cheehieu/usc-auv-kill-switch/images/IMAG0656.jpg

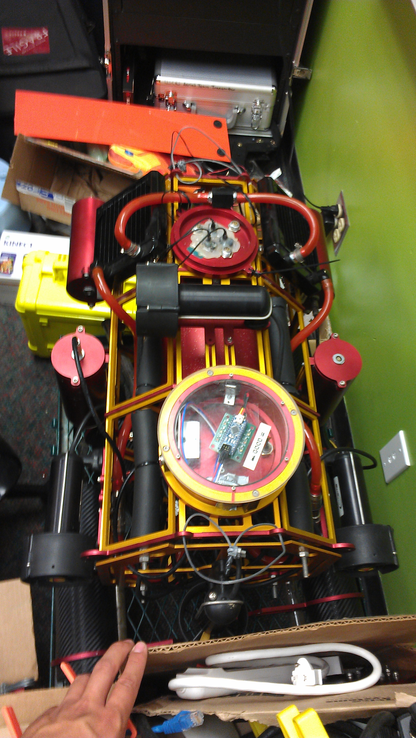
images/IMAG0656.jpg
