cheehieu/usc-auv-kill-switch/images/IMAG0652.jpg

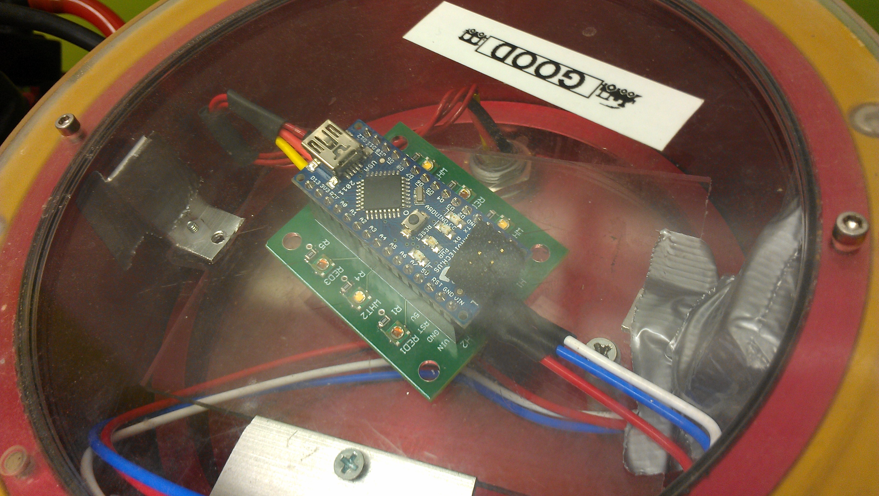
images/IMAG0652.jpg
