cheehieu/usc-auv-kill-switch/images/altium_killswitch.JPG

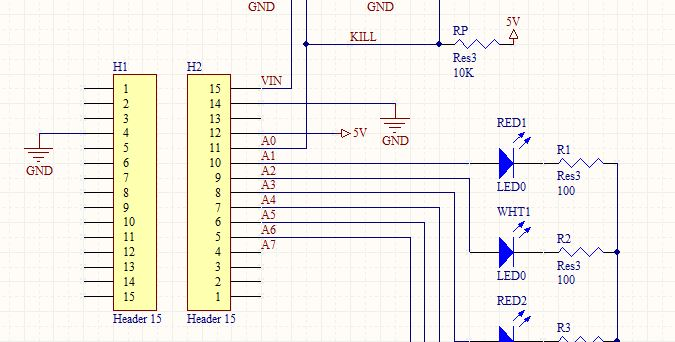
images/altium_killswitch.JPG
