cheehieu/usc-auv-kill-switch/images/CIMG3264.JPG

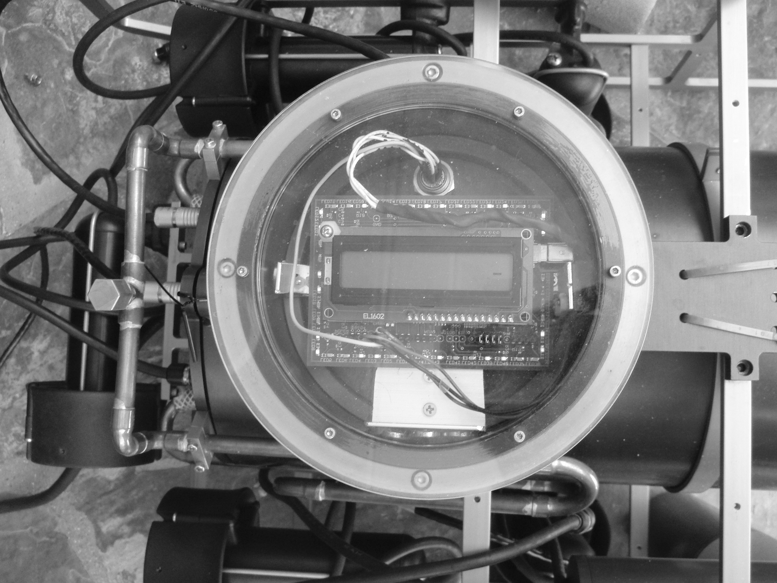
images/CIMG3264.JPG
