cheehieu/usc-auv-kill-switch/images/CIMG3785.JPG

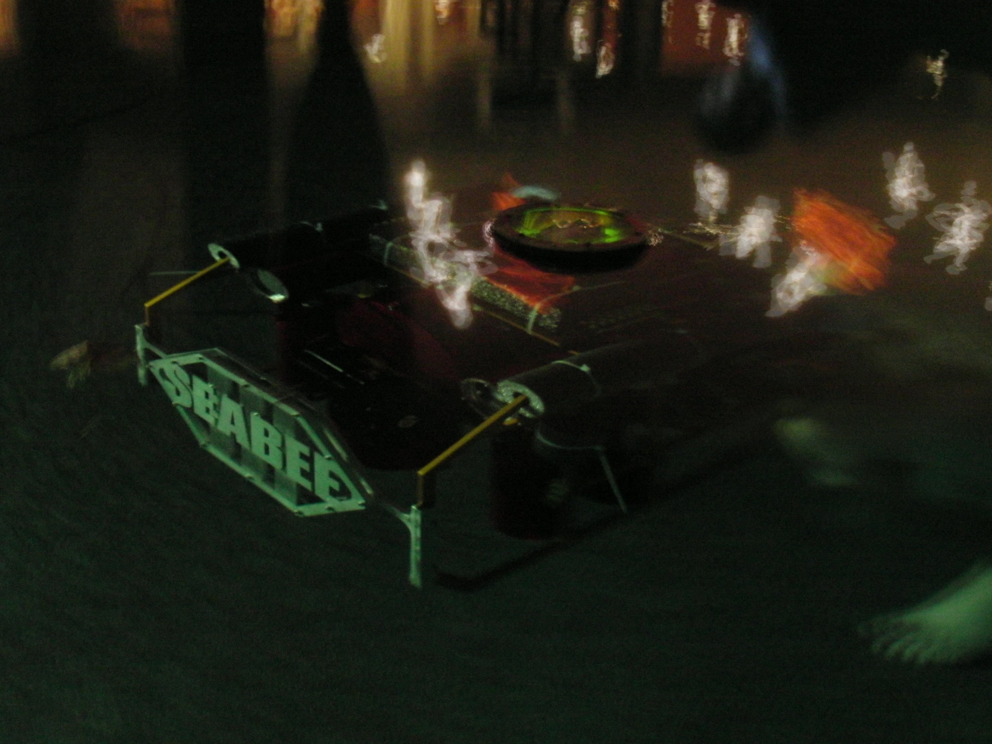
images/CIMG3785.JPG
