cheehieu/usc-auv-kill-switch/images/killswitch_rev1.png

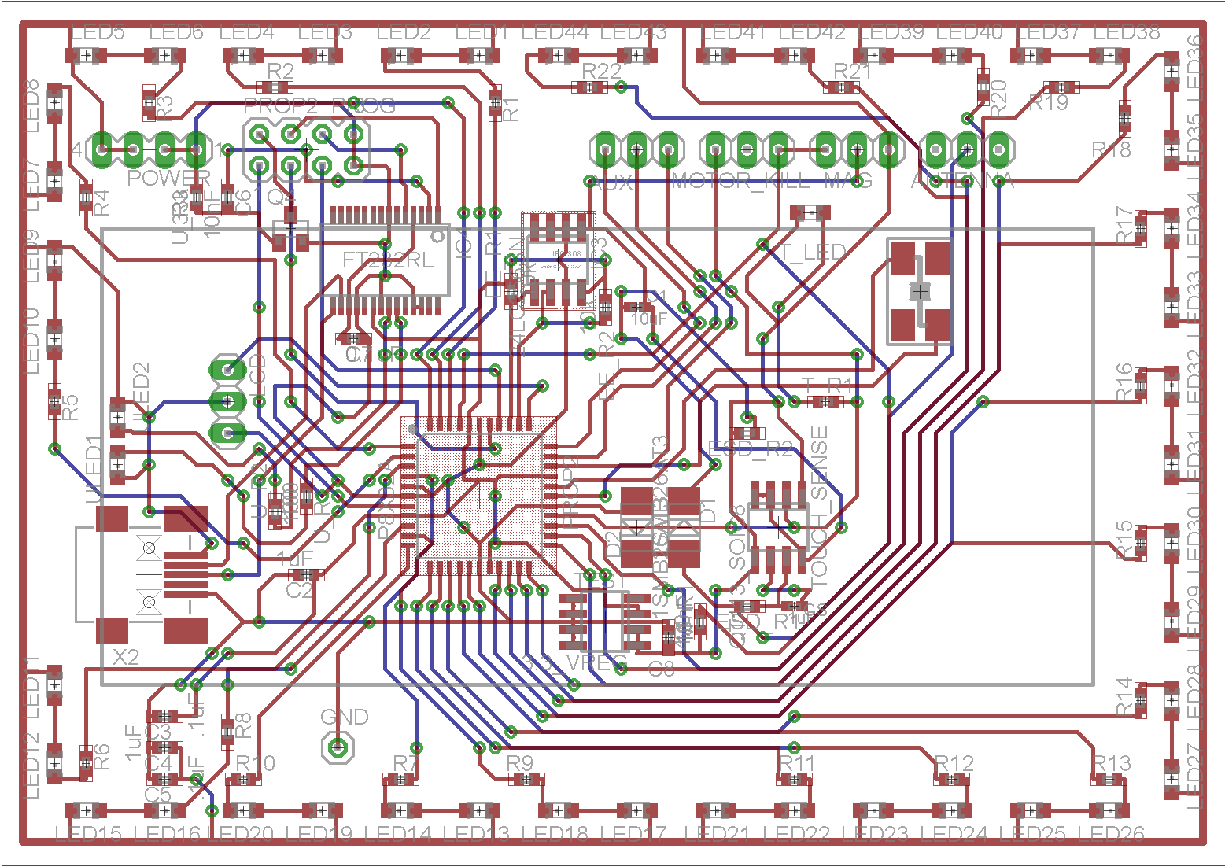
images/killswitch_rev1.png
