cheehieu/usc-auv-kill-switch/images/killswitch_rev1_sch.png

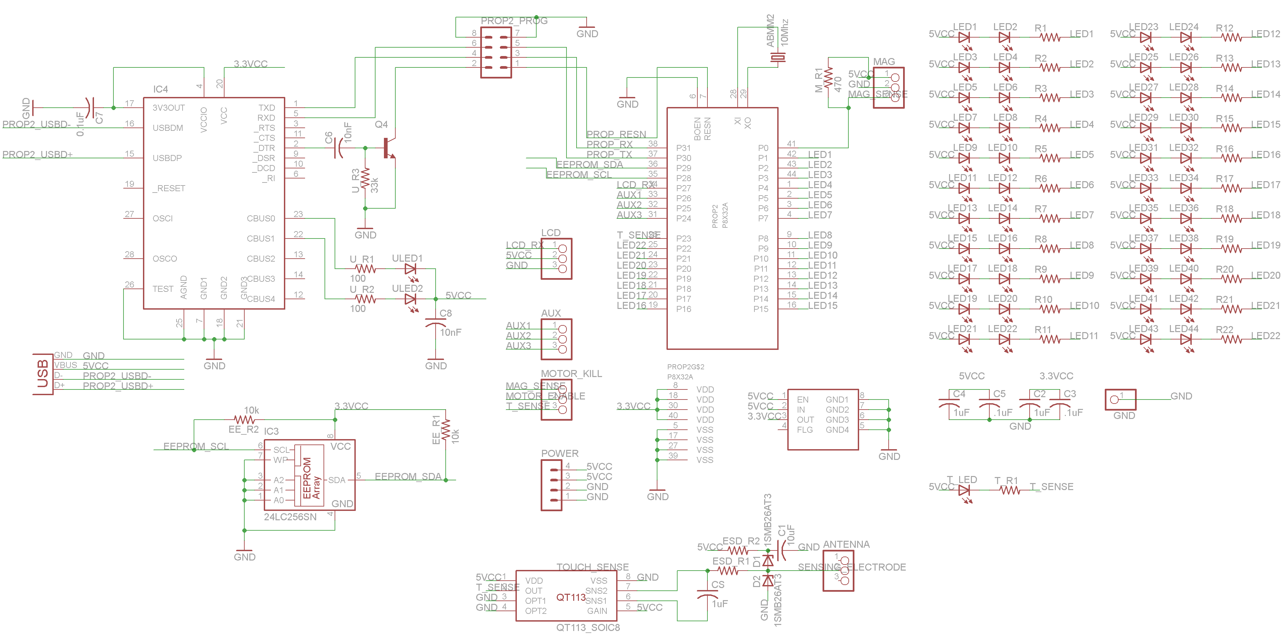
images/killswitch_rev1_sch.png
