cheehieu/usc-auv-kill-switch/hw/Arduino Mini ASSY.STEP

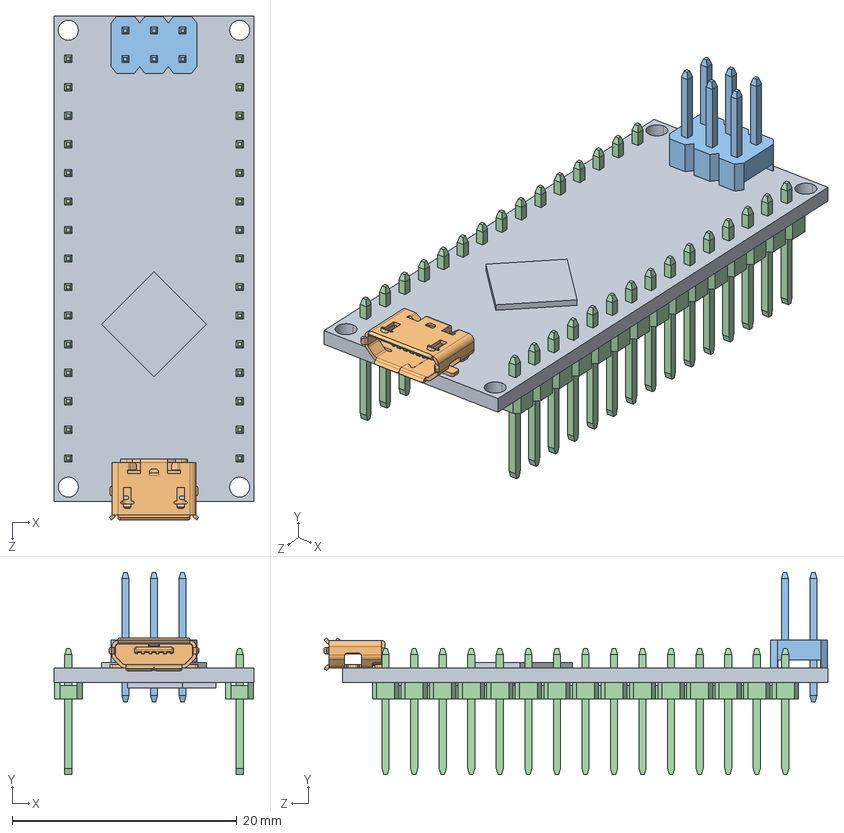
[picture p8: CAD file, 2015-04-17]
hw/Arduino Mini ASSY.STEP
17.8 x 18.0 x 44.8 mm
Arduino Mini
User Library-Micro USB
pin_header_aw254-dg-g32d_6 Pin
pin_header_aw_109_16-t_15 Pin x 2
