cheehieu/usc-auv-kill-switch/hw/killswitch.stp

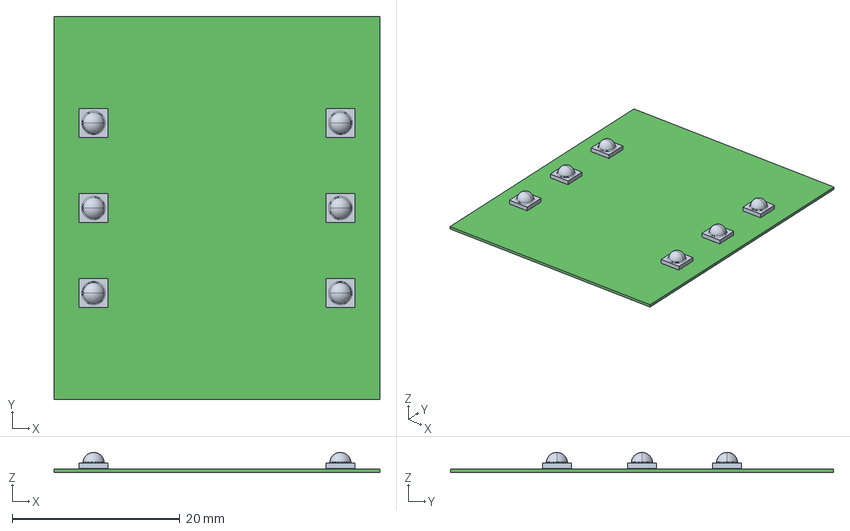
[picture p9: CAD file, 2014-12-13]
hw/killswitch.stp
38.9 x 45.7 x 2.42 mm
Board
xlamp_xp-x x 6
