cheehieu/usc-auv-kill-switch/hw/xlamp_xp-x.stp

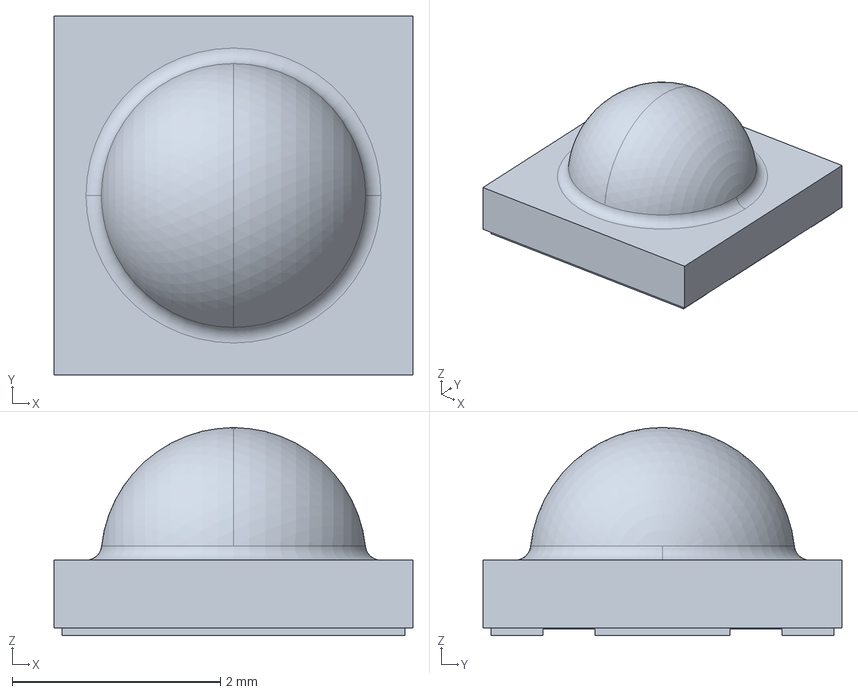
[picture p10: CAD file, 2014-12-13]
hw/xlamp_xp-x.stp
3.45 x 3.45 x 2.00 mm
