cheehieu/usc-auv-kill-switch/hw/killswitch.pdf

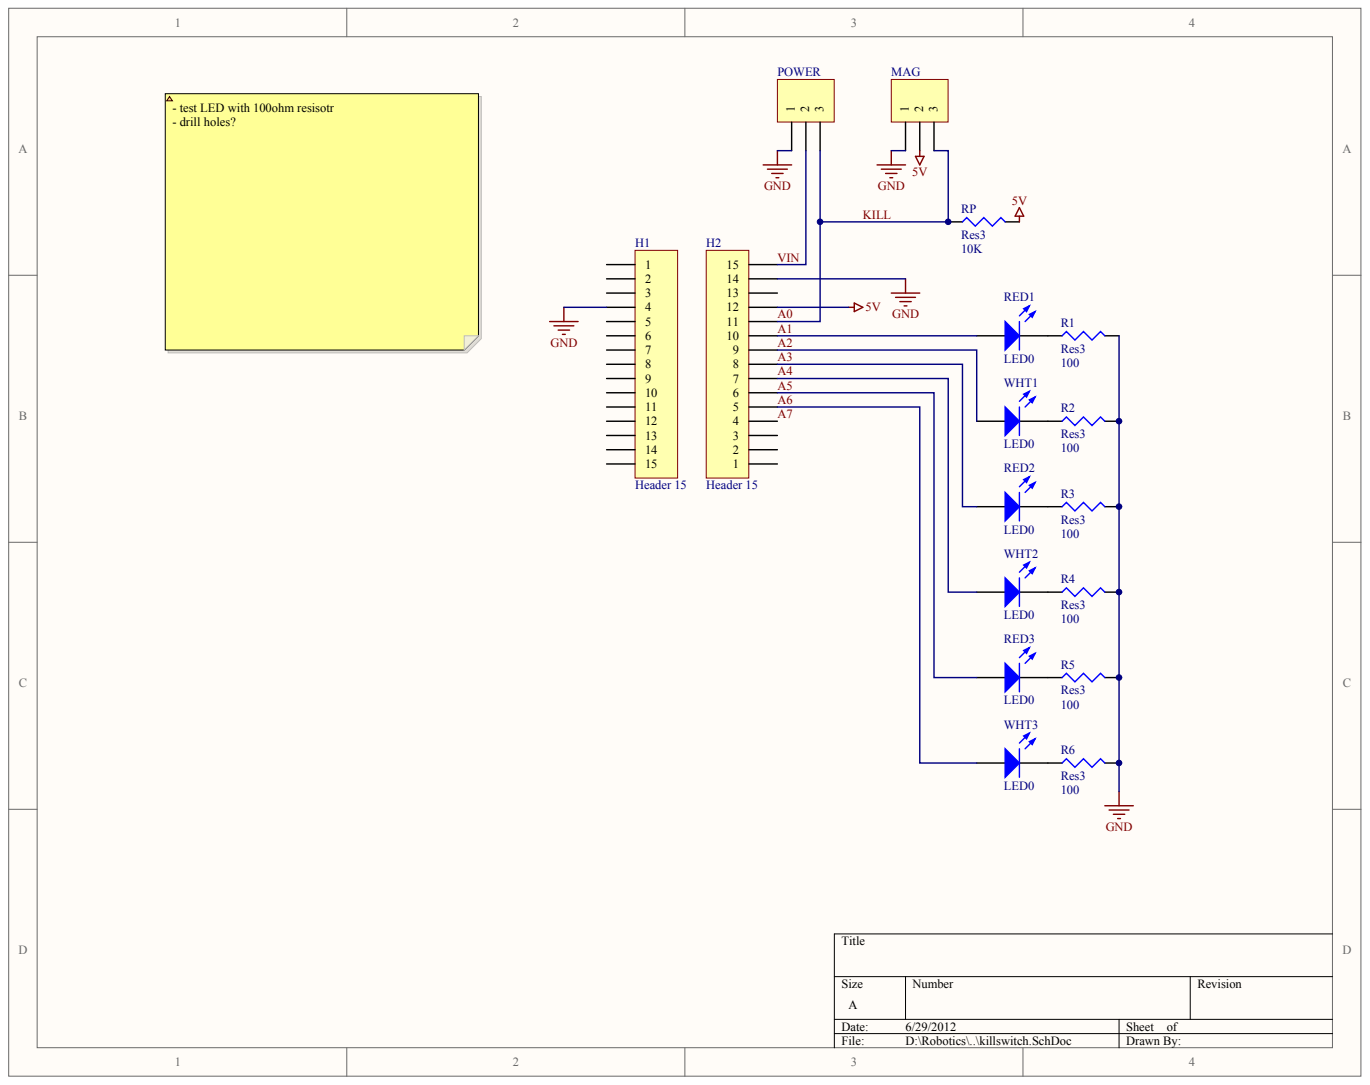
[picture p11: page 1]

- test LED with 100ohm resisotr
- drill holes?

A3
A4
A5
A6

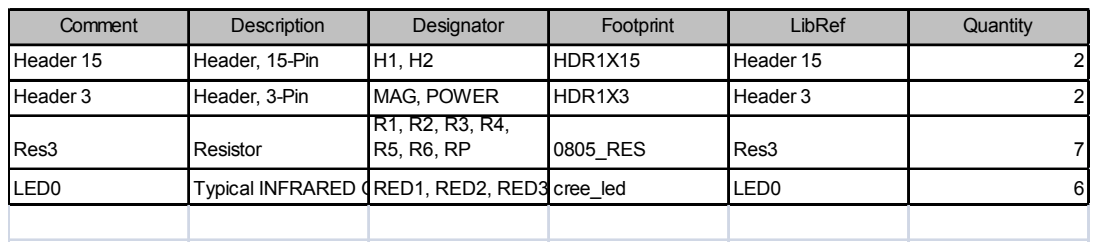
[picture p12: page 2]

Comment | Description | Designator | Footprint | LibRef | Quantity

Header 15 | Header, 15-Pin | H1, H2 | HDR1X15 | Header 15 | 2

Header 3 | Header, 3-Pin | MAG, POWER | HDR1X3 | Header 3 | 2
Res3 | Resistor | R1, R2, R3, R4, R5, R6, RP | 0805_RES | Res3 | 7

LED0 | Typical INFRARED GRED1 , RE D2, RED3 cree_led | | | LED0 | 6
