cheehieu/usc-auv-kill-switch/(list of files, drawings)

Other design files:
hw/History/killswitch.~(12).PcbDoc
hw/History/killswitch.~(20).PcbDoc
hw/History/killswitch.~(27).SchDoc
hw/History/killswitch.~(29).PcbDoc
hw/History/killswitch.~(33).PcbDoc
hw/History/killswitch.~(33).SchDoc
hw/History/killswitch.~(38).SchDoc
hw/History/killswitch.~(41).SchDoc
hw/History/killswitch.~(45).SchDoc
hw/History/killswitch.~(55).SchDoc
hw/killswitch.PcbDoc
hw/killswitch.PcbLib
hw/killswitch.PrjPCB
hw/killswitch.SchDoc
hw/Schematics/kill_switch.SchDoc
