cheehieu/usc-auv-kill-switch/(commit log)

2014-11-15 Added camera images.
2014-12-13 Added docs, hw, sw files.
    [Kill Switch.brd, Kill Switch.sch, kill_switch.SchDoc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]
2015-02-27 Added Arduino sketch.
2015-04-15 Updated README and added 3D
    [killswitch_rev2.stp]
2015-04-17 Added Arduino Nano 3d files
    [Arduino Mini ASSY.STEP, killswitch.PcbDoc, killswitch_rev2.stp]
2015-04-17 Imported Arduino step to PCB
    [killswitch.PcbDoc]
2015-04-17 Added highdef Arduino Nano 3d files
